project-hermes/hermes-board/README.md

# hermes-board
Circuit board for hermes sensor
