project-hermes/hermes-board/hermes-control-sch.png

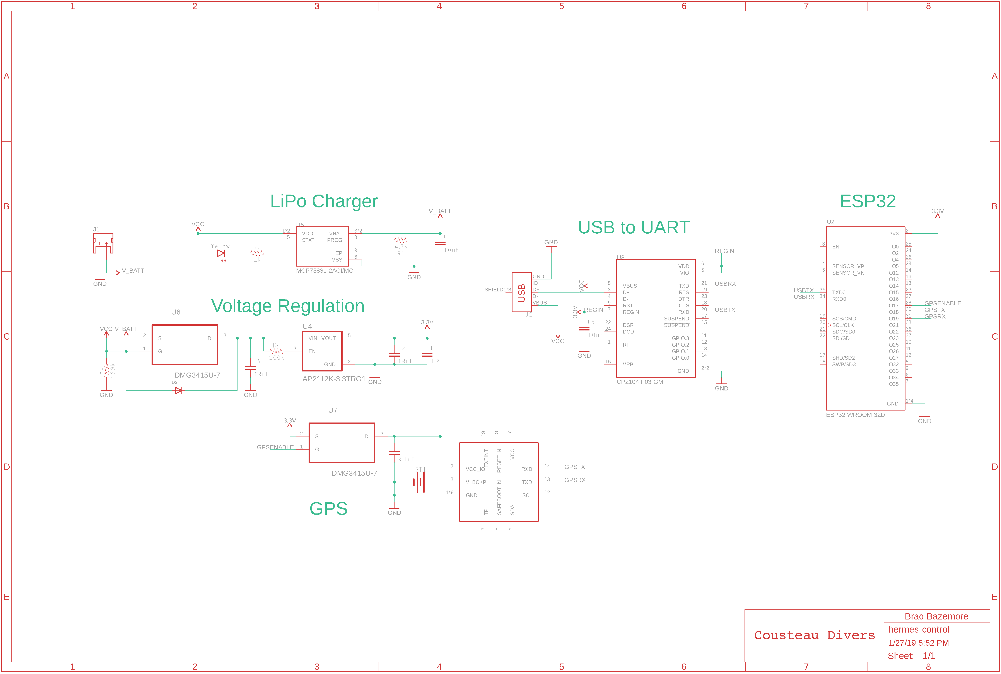
hermes-control-sch.png
