project-hermes/hermes-board/hermes-control.brd

## EAGLE design hermes-control.brd (2020-02-09)

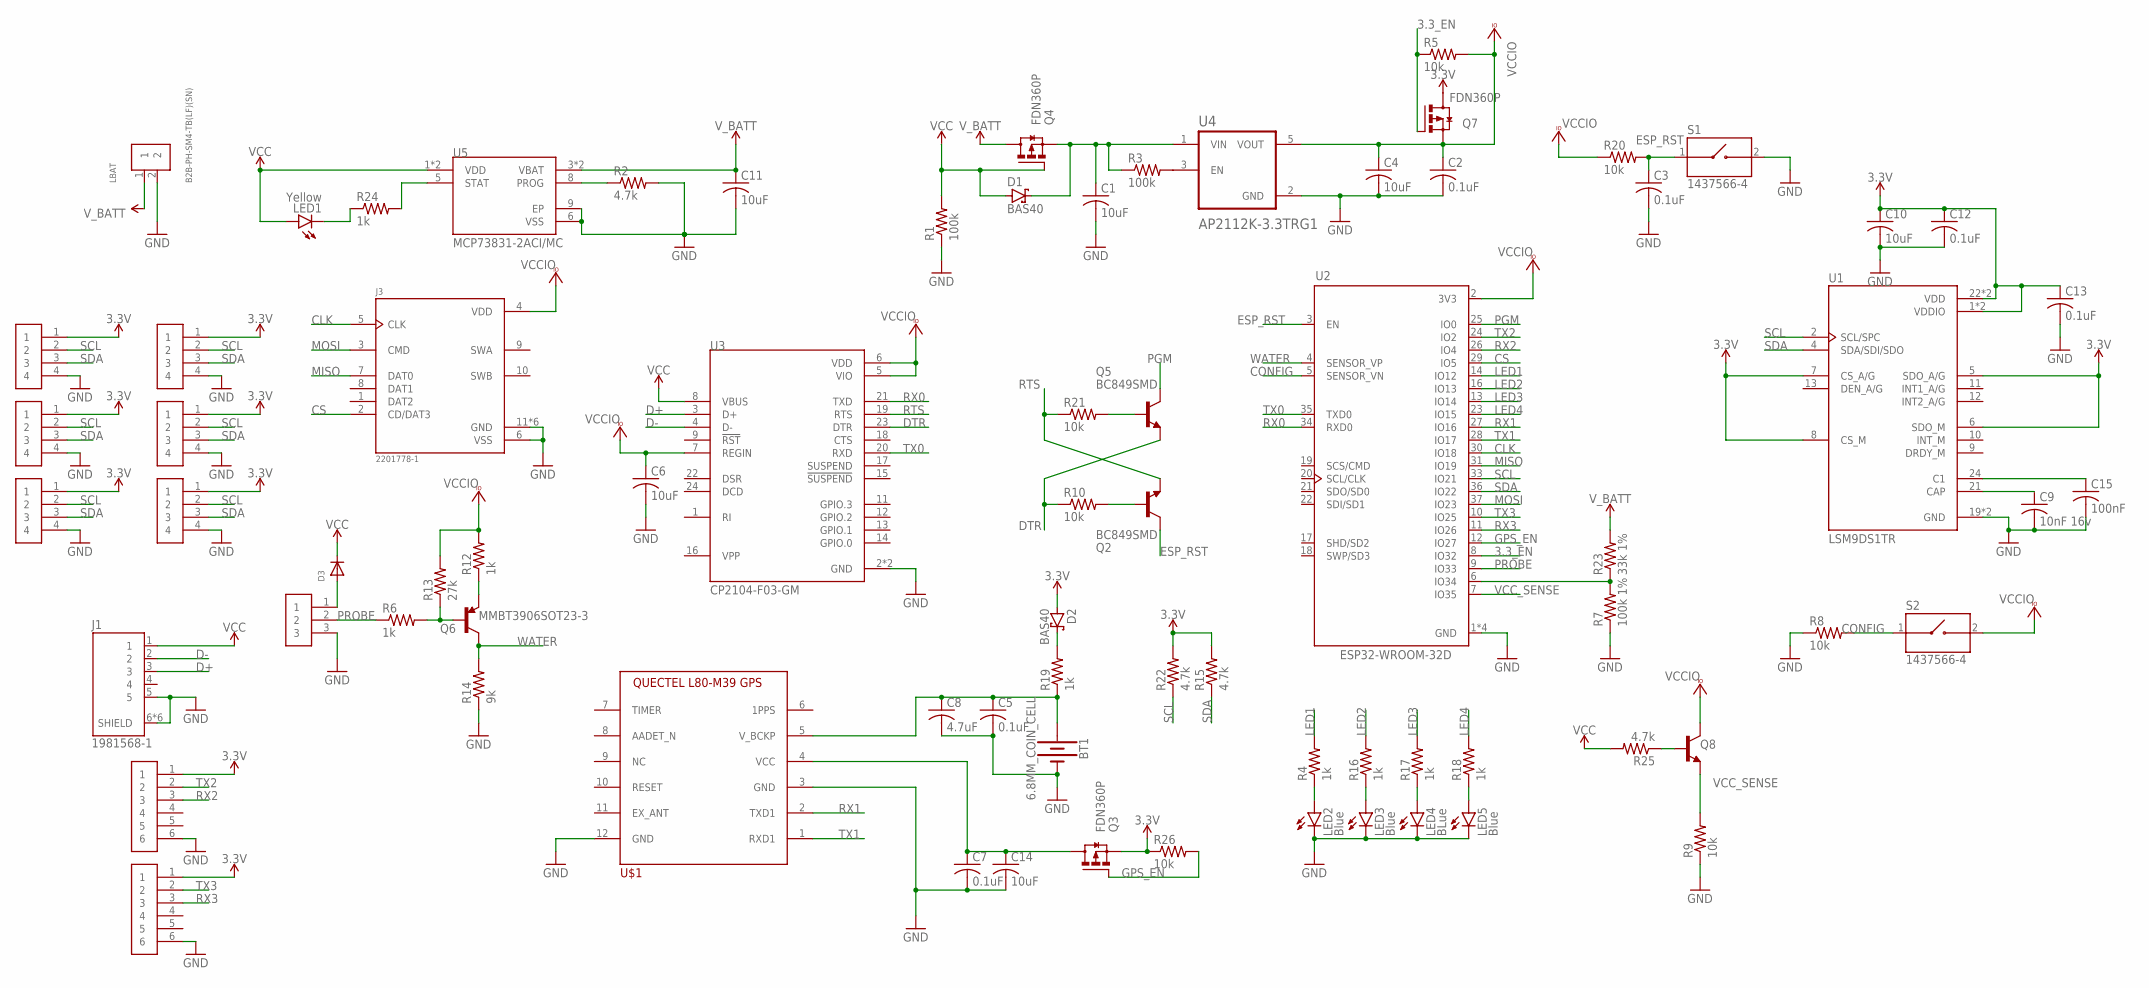
[picture p2: schematic hermes-control.sch]

Parts:
BT1: 6.8MM_COIN_CELL; BATTCON-6.8MM
C1, C4, C6, C10, C11, C14: 10uF; C0603
C2, C3, C5, C7, C12, C13: 0.1uF; C0603
C8: 4.7uF; C0603
C9: 10nF 16v; C0603
C15: 100nF; C0603
D1, D2: BAS40; SOT23
D3: DIODE_SOD-123FL; SOD-123FL
J1: 1981568-1; TE_1981568-1
J3: 2201778-1; TE_2201778-1
LBAT: B2B-PH-SM4-TB(LF)(SN); JST_B2B-PH-SM4-TB(LF)(SN)
LED1: Yellow; CHIPLED_0805
LED2, LED3, LED5: Blue; CHIPLED_0805
LED4: BLue; CHIPLED_0805
Q2, Q5: BC849SMD; SOT23-BEC
Q3, Q4, Q7: FDN360P; SUPER-SOT3
Q6: MMBT3906SOT23-3; SOT23-3
Q8: MMBT2222A; SOT23
R1, R3: 100k; R0603
R2, R15, R22, R25: 4.7k; R0603
R4, R6, R12, R16, R17, R18, R19, R24: 1k; R0603
R5, R8, R9, R10, R20, R21, R26: 10k; R0603
R7: 100k 1%; R0603
R13: 27k; R0603
R14: 9k; R0603
R23: 33k 1%; R0603
S1, S2: 1437566-4; SW_1437566-4
U1: LSM9DS1TR; PQFN43P300X350X102-24N
U2: ESP32-WROOM-32D; MODULE_ESP32-WROOM-32D
U3: CP2104-F03-GM; QFN50P400X400X80-25N
U4: AP2112K-3.3TRG1; SOT95P285X140-5N
U5: MCP73831-2ACI/MC; SON50P200X300X100-9N
U$1: L80_GNSS_MODULE; L80_PACKAGE
U$2: JST-GH-3VERT; JST-GH-TOP-3
U$3, U$4, U$5, U$9, U$10, U$11: JST-GH-4TOP; JST-GH-TOP-4
U$7, U$8: JST-GH-6TOP-ENTRY; JST-GH-TOP-6

Connections:
3.3V: C10.1, C12.1, C13.1, D2.1 (A), Q3.2 (S), Q7.3 (D), R15.2, R22.2, R26.1, U1.1 (VDDIO), U1.3 (VDDIO), U1.5 (SDO_A/G), U1.6 (SDO_M), U1.7 (CS_A/G), U1.8 (CS_M), U1.22 (VDD), U1.23 (VDD), U$3.1, U$4.1, U$5.1, U$7.1, U$8.1, U$9.1, U$10.1, U$11.1
3.3_EN: Q7.1 (G), R5.1, U2.8 (IO32)
CLK: J3.5 (CLK), U2.30 (IO18)
CONFIG: R8.2, S2.1, U2.5 (SENSOR_VN)
CS: J3.2 (CD/DAT3), U2.29 (IO5)
D+: J1.3, U3.3 (D+)
D-: J1.2, U3.4 (D-)
DTR: Q5.E, R10.1, U3.23 (DTR)
ESP_RST: C3.1, Q2.C, R20.2, S1.1, U2.3 (EN)
GND: BT1.-, C1.2, C2.2, C3.2, C4.2, C5.2, C6.2, C7.2, C8.2, C9.2, C10.2, C11.2, C12.2, C13.2, C14.2, C15.2, J1.5, J1.6 (SHIELD), J1.7 (SHIELD), J1.8 (SHIELD), J1.9 (SHIELD), J1.10 (SHIELD), J1.11 (SHIELD), J3.6 (VSS), J3.11 (GND), J3.12 (GND), J3.13 (GND), J3.14 (GND), J3.15 (GND), J3.16 (GND), LBAT.2, LED2.C, LED3.C, LED4.C, LED5.C, R1.1, R2.2, R7.1, R8.1, R9.1, R14.1, S1.2, U1.19 (GND), U1.20 (GND), U2.1 (GND), U2.15 (GND), U2.38 (GND), U2.39 (GND), U3.2 (GND), U3.25 (GND), U4.2 (GND), U5.6 (VSS), U5.9 (EP), U$1.3 (GND), U$1.12 (GND), U$2.3, U$3.4, U$4.4, U$5.4, U$7.6, U$8.6, U$9.4, U$10.4, U$11.4
GPS_EN: Q3.1 (G), R26.2, U2.12 (IO27)
IO13: R7.2, R23.1, U2.6 (IO34)
LED1: R4.2, U2.14 (IO12)
LED2: R16.2, U2.16 (IO13)
LED3: R17.2, U2.13 (IO14)
LED4: R18.2, U2.23 (IO15)
MISO: J3.7 (DAT0), U2.31 (IO19)
MOSI: J3.3 (CMD), U2.37 (IO23)
unnamed: R2.1, U5.8 (PROG)
unnamed: R24.2, U5.5 (STAT)
unnamed: LED1.C, R24.1
unnamed: C1.1, D1.3 (C), Q4.2 (S), R3.1, U4.1 (VIN)
unnamed: R3.2, U4.3 (EN)
unnamed: C7.1, C14.1, Q3.3 (D), U$1.4 (VCC)
unnamed: D3.A, U$2.1
unnamed: C9.1, U1.21 (CAP)
unnamed: C15.1, U1.24 (C1)
unnamed: Q6.1 (B), R6.2, R13.1
unnamed: Q6.2 (E), R12.1
unnamed: BT1.+, C5.1, C8.1, R19.1, U$1.5 (V_BCKP)
unnamed: D2.3 (C), R19.2
unnamed: LED2.A, R4.1
unnamed: LED3.A, R16.1
unnamed: Q2.B, R10.2
unnamed: Q5.B, R21.2
unnamed: LED4.A, R17.1
unnamed: LED5.A, R18.1
unnamed: Q8.1 (B), R25.1
PGM: Q5.C, U2.25 (IO0)
PROBE: R6.1, U2.9 (IO33), U$2.2
RTS: Q2.E, R21.1, U3.19 (RTS)
RX0: U2.34 (RXD0), U3.21 (TXD)
RX1: U2.27 (IO16), U$1.2 (TXD1)
RX2: U2.26 (IO4), U$7.3
RX3: U2.11 (IO26), U$8.3
SCL: R22.1, U1.2 (SCL/SPC), U2.33 (IO21), U$3.2, U$4.2, U$5.2, U$9.2, U$10.2, U$11.2
SDA: R15.1, U1.4 (SDA/SDI/SDO), U2.36 (IO22), U$3.3, U$4.3, U$5.3, U$9.3, U$10.3, U$11.3
TX0: U2.35 (TXD0), U3.20 (RXD)
TX1: U2.28 (IO17), U$1.1 (RXD1)
TX2: U2.24 (IO2), U$7.2
TX3: U2.10 (IO25), U$8.2
VCC: D1.1 (A), D3.C, J1.1, LED1.A, Q4.1 (G), R1.2, R25.2, U3.8 (VBUS), U5.1 (VDD), U5.2 (VDD)
VCCIO: C2.1, C4.1, C6.1, J3.4 (VDD), Q7.2 (S), Q8.3 (C), R5.2, R12.2, R13.2, R20.1, S2.2, U2.2 (3V3), U3.5 (VIO), U3.6 (VDD), U3.7 (REGIN), U4.5 (VOUT)
VCC_SENSE: Q8.2 (E), R9.2, U2.7 (IO35)
V_BATT: C11.1, LBAT.1, Q4.3 (D), R23.2, U5.3 (VBAT), U5.4 (VBAT)
WATER: Q6.3 (C), R14.2, U2.4 (SENSOR_VP)

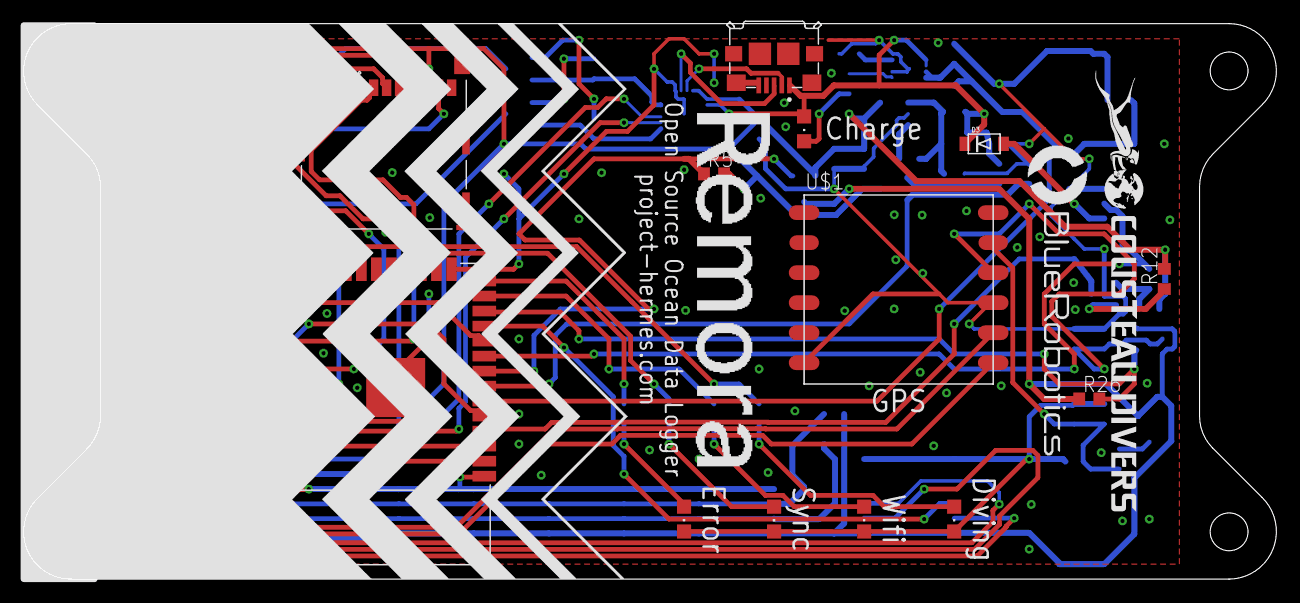
[picture p3: board hermes-control.brd from above]

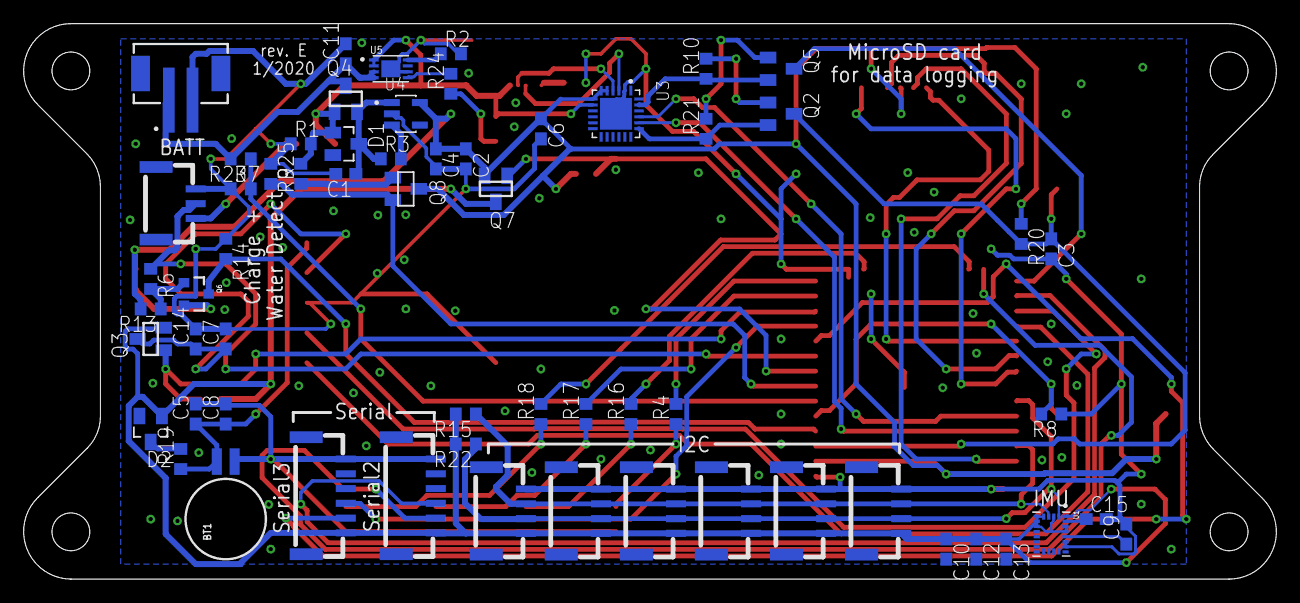
[picture p4: board hermes-control.brd from below]

Board: 2 copper layers, 106.0 x 47.0 mm, 80 parts (61 on the bottom side), 56 nets.

Other parts of the board:
U$6: REMORA-SILKSCREEN-CHEVRON
U$12: BR-FULL-LOGO-MEDIUM
U$13: COUSTEAU-DIVERS-LOGO-MEDIUM
U$15: REMORA-TEXT-INTER
