project-hermes/hermes-board/main-board.brd

## EAGLE design main-board.brd (2019-01-27)

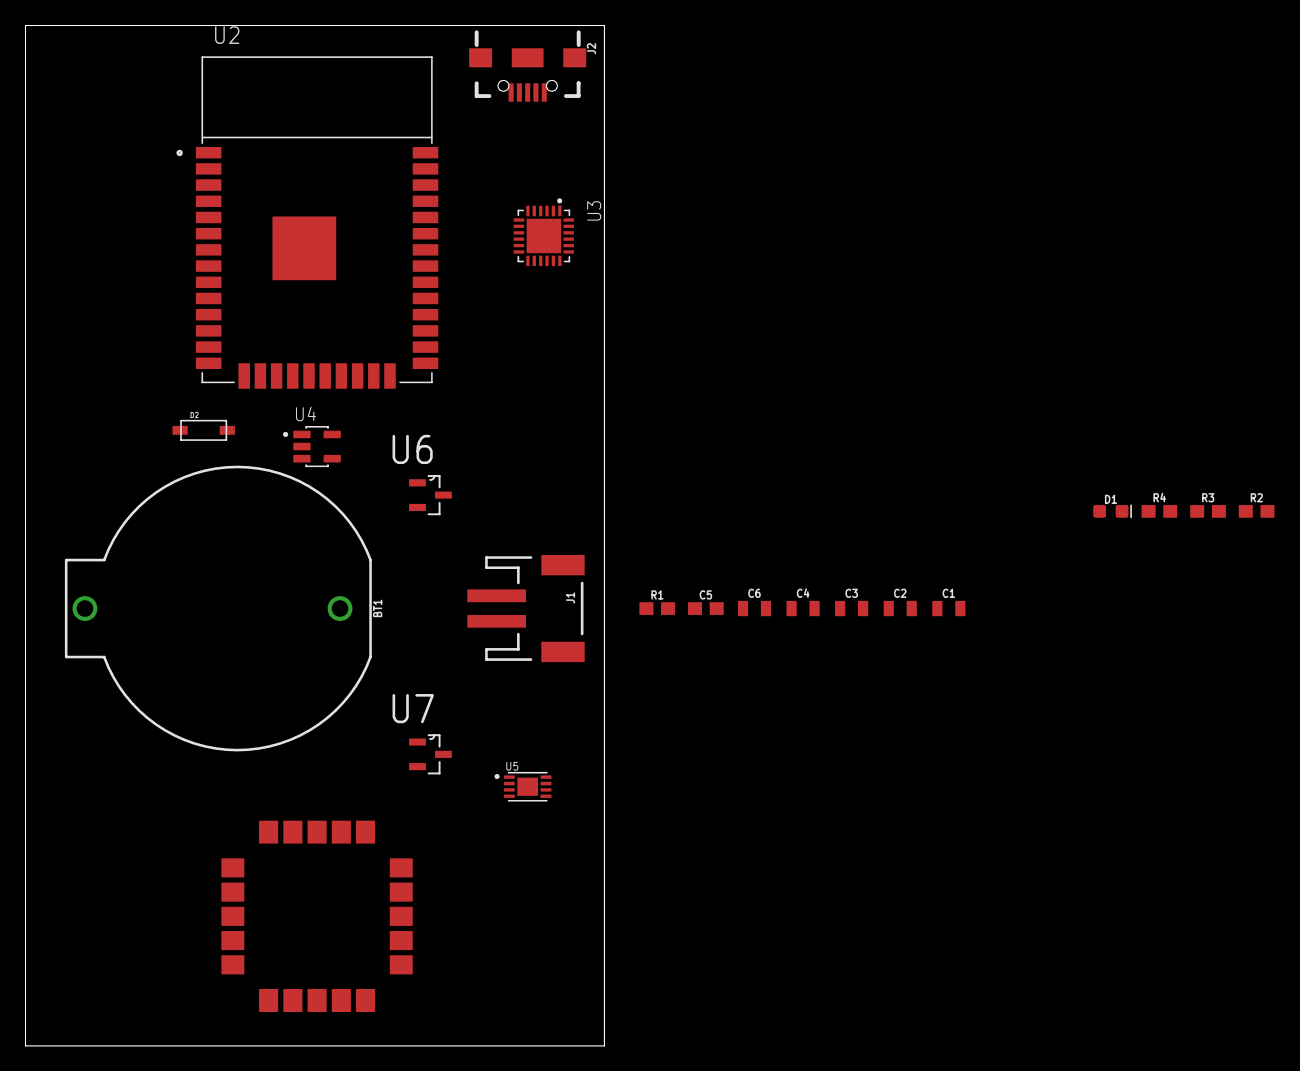
[picture p5: board main-board.brd from above]

Board: 2 copper layers, 45.4 x 80.0 mm, 22 parts (0 on the bottom side), 19 nets, no tracks yet.

Parts:
BT1: BATTCOM_20MM_PTH
C1, C2, C4, C6: 10uF; 0805
C3: 1.0uF; 0805
C5: 0.1uF; 0603
D1: Yellow; LED-0603
D2: SOD-123
IC1: SAM-M8Q
J1: JST-2-SMD
J2: USB-B-MICRO-SMD
R1: 4.7k; 0603
R2: 1k; 0603
R3, R4: 100k; 0603
U2: ESP32-WROOM-32D; MODULE_ESP32-WROOM-32D
U3: CP2104-F03-GM; QFN50P400X400X80-25N
U4: AP2112K-3.3TRG1; SOT95P285X140-5N
U5: MCP73831-2ACI/MC; SON50P200X300X100-9N
U6, U7: DMG3415U-7; SOT95P240X105-3N

Connections:
3.3V: C2.1, C3.1, U2.2, U4.5, U7.2
GND: BT1.2, C1.2, C2.2, C3.2, C4.2, C5.2, C6.2, IC1.1, IC1.4, IC1.5, IC1.6, IC1.10, IC1.11, IC1.15, IC1.16, IC1.20, J1.1, J2.GND, R1.2, R3.1, U2.1, U2.15, U2.38, U2.39, U3.2, U3.25, U4.2, U5.6
GPSENABLE: U2.28, U7.1
GPSRX: IC1.13, U2.31
GPSTX: IC1.14, U2.30
unnamed: R1.1, U5.8
unnamed: R2.2, U5.5
unnamed: D1.C, R2.1
unnamed: C4.1, D2.C, R4.1, U4.1, U6.3
unnamed: R4.2, U4.3
unnamed: C5.1, IC1.2, IC1.17, U7.3
unnamed: BT1.1, IC1.3
unnamed: J2.D+, U3.3
unnamed: J2.D-, U3.4
REGIN: C6.1, U3.5, U3.6, U3.7
USBRX: U2.34, U3.21
USBTX: U2.35, U3.20
VCC: D1.A, D2.A, J2.VBUS, R3.2, U3.8, U5.1, U5.2, U6.1
V_BATT: C1.1, J1.2, U5.3, U5.4, U6.2
