project-hermes/hermes-board/(commit log)

2019-01-24 create power managment
    [main-board.sch]
2019-01-24 added board
    [main-board.sch]
2019-01-24 added board design
    [main-board.brd, main-board.sch]
2019-01-27 added new board
    [hermes-control.brd]
2019-01-28 new gps and new layout
    [hermes-control.brd, hermes-control.sch]
2019-02-26 added sd, leds, buttons, and clean up
    [hermes-control.brd, hermes-control.sch]
2019-02-27 added i2c connetions and buss
    [hermes-control.sch]
2019-02-28 added uart serial ports
    [hermes-control.sch]
2019-02-28 added 9DOF IMU
    [hermes-control.sch]
2019-03-07 added the board layout
    [hermes-control.brd, hermes-control.sch]
2019-03-19 updated componets to match bom
    [hermes-control.brd, hermes-control.sch]
2019-04-02 started to wries a few things
    [hermes-control.brd, hermes-control.sch]
2019-04-04 stuck trying to finish wiring
    [hermes-control.brd]
2019-04-08 everything is connected but ground
    [hermes-control.brd]
2019-04-08 it is done
    [hermes-control.brd, hermes-control.sch]
2019-04-16 lets clean this up
    [hermes-control.brd, hermes-control.sch]
2019-04-16 replaced all componets with generics
    [hermes-control.brd, hermes-control.sch]
2019-04-17 addresed issue comments
    [hermes-control.brd, hermes-control.sch]
2019-04-18 updated resistors and addressed comments
    [hermes-control.brd, hermes-control.sch]
2019-04-23 updated GPIO
    [hermes-control.brd, hermes-control.sch]
2019-04-25 addressed more reviews
    [hermes-control.brd, hermes-control.sch]
2019-05-01 added two more i2c connections
    [hermes-control.brd, hermes-control.sch]
2019-05-04 Update board outline.
    [hermes-control.brd, hermes-control.sch]
2019-05-04 new layout with main componets
    [hermes-control.brd, hermes-control.sch]
2019-05-05 all componets placed
    [hermes-control.brd, hermes-control.sch]
2019-05-05 routed single sides with no vias
    [hermes-control.brd, hermes-control.sch]
2019-05-05 ripped up all signal
    [hermes-control.brd]
2019-05-05 almost everything is connected
    [hermes-control.brd, hermes-control.sch]
2019-05-06 all connections made
    [hermes-control.brd]
2019-05-06 added gnd plane
    [hermes-control.brd]
2019-05-06 fixed air wires and isolated 0.1
    [hermes-control.brd]
2019-05-06 adjusted vias and ground planes
    [hermes-control.brd]
2019-05-07 added test and cleaned up ground plane
    [hermes-control.brd]
2019-05-09 more changes and dimension is stuck
    [hermes-control.brd]
2019-05-10 removed deminsion
    [hermes-control.brd]
2019-05-10 more gnd
    [hermes-control.brd]
2019-05-31 flip sd card and connect vcc to usb uart chip
    [hermes-control.brd, hermes-control.sch]
2019-06-01 new bat connector
    [hermes-control.brd, hermes-control.sch]
2019-06-26 flipped fet
    [hermes-control.brd, hermes-control.sch]
2019-06-26 changed from 3.3 to vccio
    [hermes-control.brd, hermes-control.sch]
2019-06-28 changed batt connection
    [hermes-control.brd, hermes-control.sch]
2019-08-05 more vccio
    [hermes-control.brd, hermes-control.sch]
2019-08-07 Answers to Questions: - ESP32_RST looks like it should be a 0.1uF not 1uF (p15) -- fixed - similarly, the reference decoupling caps for 3V3 (pin 2) are 10uF and 0.1uF but you have 10uF and 1uF (on VC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
    [hermes-control.brd, hermes-control.sch]
2019-08-10 updated resisotrs
    [hermes-control.brd]
2019-12-05 Update silkscreen design and add logos to library.
    [hermes-control.brd]
2020-01-26 Change silkscreen back to Remora and clean up lots of small things.
    [hermes-control.brd, hermes-control.sch]
2020-01-27 Move one label that was under SMT components.
    [hermes-control.brd]
